onzebaandert/lora-tuinmeetnet-v2/docs/FSD_LoRa_tuinmeetnet_v0_3.docx

Functioneel Specificatie Document

LoRa tuinmeetnet met RTC-gestuurde soil nodes, aggregator, LoRa uplink en MQTT-ontvangst

Versie | 0.2 conceptupdate
Datum | 18 april 2026
Doel | Vastleggen van de functionele werking, timing, hardware-architectuur en interfaces van het huidige veldsysteem.
Reikwijdte | SOIL1, SOIL2, Aggregator, XIAO C3 LoRa node, Heltec LoRa zender, T-Beam/receiver, MQTT, Node-RED, InfluxDB en Grafana.

Dit document vervangt de eerdere conceptversie door expliciet vast te leggen dat de systeemtiming door DS3231-RTC-modules wordt bepaald en door aanvullende hardware- en functiebeschrijvingen voor de soil nodes en aggregator op te nemen.

# 1. Doel en scope

Het project realiseert een energiezuinig tuinmeetnet waarin twee XIAO ESP32-C3 soil nodes via ESP-NOW rapporteren aan een XIAO ESP32-C3 aggregator. De aggregator stuurt een compact vast uplinkframe door naar een XIAO C3 LoRa node. Deze zet de informatie om naar een JSON-regel voor een Heltec LoRa-zender, die de payload via LoRa verstuurt naar een ontvangerlaag (bijvoorbeeld T-Beam), waarna publicatie naar MQTT, parsing in Node-RED en opslag in InfluxDB/Grafana plaatsvindt.

Binnen scope vallen de functionele datastroom, de node-rollen, de timing op basis van DS3231-RTC, de payloaddefinities, de energiehuishouding en de softwarematige verantwoordelijkheden per node. Buiten scope vallen mechanische constructie, waterdichte behuizing, langdurige milieuvalidatie, formele EMC-certificering en productierijpe beveiliging.

# 2. Systeemcontext en hoofdketen

De functionele hoofdketen van het systeem is lineair, maar de betrouwbaarheid wordt vergroot door gefaseerde wake-momenten, ACK-mechanismen en herhaalde uplinktransmissies in de tussenlaag.

Laag / node | Primaire hardware | Transport | Hoofdfunctie
SOIL1 | XIAO ESP32-C3 + DS3231 + RS485 + CWT sensor | Modbus RTU + ESP-NOW | Leest vocht, temperatuur, EC en pH; stuurt SoilPacket met ACK-afhandeling.
SOIL2 | XIAO ESP32-C3 + DS3231 + RS485 + ZTS sensor | Modbus RTU + ESP-NOW | Leest vocht en temperatuur; stuurt SoilPacket met ACK-afhandeling.
Aggregator | XIAO ESP32-C3 + DS3231 | ESP-NOW | Ontvangt SoilPackets, ACKt zenders, verrijkt met eigen batterij/case-temp en bouwt vaste AggUplink97.
LoRa node C3 | XIAO ESP32-C3 + DS3231 + MOSFET + UART | ESP-NOW + UART | Luistert naar AggUplink97, converteert naar compacte JSON en voedt de Heltec alleen tijdens uplink.
Heltec LoRa zender | Heltec board met SX1262 | LoRa | Zend de ontvangen JSON-payload via LoRa uit.
Receiver | T-Beam V1 of vergelijkbare RX-node | LoRa + WiFi + MQTT | Ontvangt LoRa, voegt LoRa RSSI/SNR toe en publiceert naar MQTT.
Applicatielaag | Node-RED + InfluxDB + Grafana | MQTT | Parseert payloads, splitst measurements en visualiseert/corrigeert trends.

# 3. Hardware-architectuur per node

## 3.1 Soil nodes (gemeenschappelijk patroon)

Beide soil nodes zijn gebaseerd op een XIAO ESP32-C3 en gebruiken een DS3231-RTC voor phase-aligned deep-sleep wakes. De externe RS485-sensor wordt via een MOSFET alleen tijdens de meetfase van spanning voorzien. Daarmee wordt rustverbruik beperkt en wordt de sensorinterface buiten de actieve meetvensters ontkoppeld.

- Controller: XIAO ESP32-C3.
- RTC: DS3231 op I2C; INT-lijn naar WAKE_PIN voor deep-sleep wake.
- Sensorbus: RS485 transceiver met DE/RE-direction control.
- Voedingsbesparing: sensorvoeding via MOSFET, alleen actief tijdens sensor warm-up en Modbus-uitlezing.
- Lokale metingen: accuspanning (VBAT) en case temperature via DS3231 interne temperatuursensor.
- Communicatie naar aggregator: ESP-NOW op kanaal 6 met ACK-wachtvenster en retries.

## 3.2 SOIL1

SOIL1 gebruikt een CWT Modbus-sensor. De huidige code leest adres 1 op 4800 baud met functie 0x03 vanaf register 0x0000, lengte 7. Functioneel levert SOIL1 bodemtemperatuur, vocht, EC en pH, plus lokale case temperature en batterijspanning.

- Meetwaarden in payload: soil temperature, soil humidity, EC raw, pH, case temperature en vbat.
- Wachtprofiel: sensor warm-up 2500 ms, maximaal 5 Modbus-pogingen.
- ESP-NOW identificatie: SoilPacket.id = 1.
- Fase in 5-minutencyclus: PHASE_SECOND = 8.

## 3.3 SOIL2

SOIL2 gebruikt een ZTS Modbus-sensor. De huidige code leest adres 1 op 4800 baud met functie 0x04 vanaf register 0x0000, lengte 2. Functioneel levert SOIL2 bodemtemperatuur en vocht, plus lokale case temperature en batterijspanning.

- Meetwaarden in payload: soil temperature, moisture percentage, case temperature en vbat.
- Wachtprofiel: sensor warm-up 3200 ms, maximaal 5 Modbus-pogingen.
- ESP-NOW identificatie: SoilPacket.id = 2.
- Fase in 5-minutencyclus: PHASE_SECOND = 16.

## 3.4 Aggregator (AGG)

De aggregator is eveneens een XIAO ESP32-C3 met DS3231. Deze node luistert na wake gedurende een vast venster naar binnenkomende SoilPackets. Voor elke geaccepteerde soil node wordt de ontvangen sensorinhoud opgeslagen en wordt de ontvangen ESP-NOW RSSI in Soil22.rsv0 (low byte, int8) weggeschreven. Daarnaast leest de AGG zijn eigen batterijspanning en case temperature.

- Luistervenster: LISTEN_MS = 30000 ms.
- Fase in 5-minutencyclus: WAKE_SECOND = 5.
- ACK: 8-byte Ack met session_id, seq en ok-flag.
- Ondersteuning voor drie externe bronnodes; in de huidige specificatie zijn SOIL1 en SOIL2 volledig benoemd, de derde bron blijft reserve/optioneel.
- Uplink naar mesh/LoRa node: 97-byte AggUplink97, momenteel acht keer verzonden met 250 ms tussenruimte.

## 3.5 LoRa uplinknode en ontvangerlaag

Na aggregatie wordt de data door een aparte XIAO C3 LoRa node ontvangen. Deze node luistert via ESP-NOW naar de 97-byte aggregator-uplink, bouwt een compacte JSON-string, schakelt via een MOSFET de Heltec LoRa-zender in en levert de JSON via UART aan. De Heltec verzorgt uitsluitend de LoRa-uitzending. Aan de ontvangende zijde wordt in de huidige opstelling een T-Beam gebruikt om LoRa te ontvangen en naar MQTT te publiceren.

- XIAO C3 LoRa node: DS3231-gestuurde wake, ESP-NOW ontvangst, JSON-opbouw, MOSFET power gating voor Heltec en UART-bridge.
- Heltec zender: leest één UART-regel en zendt deze via LoRa uit; testsketches kunnen ook zelfstandig periodieke testberichten uitzenden.
- T-Beam receiver: voegt LoRa RSSI/SNR aan het bericht toe en publiceert naar MQTT.

# 4. RTC-timing en wake-orchestratie

Een kernpunt van dit project is dat de timing van het volledige systeem op DS3231-RTC-modules is gebaseerd. De RTC bepaalt per node wanneer de deep-sleep wordt verlaten en maakt daarmee de communicatieketen deterministic genoeg om energiezuinig te blijven. Zonder dit mechanisme zouden soil nodes, aggregator en uplinknode elkaar vaak missen.

Alle XIAO-gebaseerde nodes gebruiken DS3231 Alarm1 in interruptmodus. De INT-lijn trekt WAKE_PIN laag; vervolgens wordt de volgende wake direct na afloop van de cyclus opnieuw in de RTC geprogrammeerd. Alleen bij een RTC-leesfout valt de code terug op timer-based wake.

Node | Cyclustijd | Fase-seconde | Functionele betekenis
Aggregator | 5 min | 05 | Wordt vroeg in de cyclus wakker en luistert 30 s naar soil nodes.
SOIL1 | 5 min | 08 | Meet, voedt sensor kortstondig, verstuurt SoilPacket en wacht op ACK.
SOIL2 | 5 min | 16 | Meet, voedt sensor kortstondig, verstuurt SoilPacket en wacht op ACK.
LoRa node C3 | 5 min | 05 | Wordt tegelijk met AGG wakker zodat de daaropvolgende uplink binnen het luistervenster valt.

Tabel 1. Fasegebaseerde timing van de huidige implementatie.

De gekozen seconden 05, 08 en 16 reduceren de kans op overlap tussen soil nodes en zorgen dat de AGG en LoRa node al actief zijn voordat de sensornodes hun meting afronden. Functioneel betekent dit dat timing niet alleen een optimalisatie is, maar een onderdeel van het protocolontwerp.

# 5. Functionele werking per cyclus

## 5.1 Soil node cyclus

- Node wordt gewekt door DS3231 Alarm1.
- Node leest lokale batterijspanning en case temperature.
- Node schakelt RS485-sensor via MOSFET in, wacht op warm-up en voert Modbus-uitlezing uit.
- Meetdata wordt verpakt in SoilPacket (28 bytes).
- Packet wordt via ESP-NOW naar AGG verstuurd; de node wacht op ACK en doet maximaal twee retries wanneer nodig.
- Na afloop wordt de volgende RTC-alarmering berekend en gaat de node terug naar deep sleep.

## 5.2 Aggregatorcyclus

- AGG wordt gewekt door DS3231 en activeert WiFi STA + ESP-NOW op het vaste kanaal.
- Gedurende 30 s worden SoilPackets ontvangen, gevalideerd op magic en bron-MAC, en per node opgeslagen.
- Voor elk geldig packet wordt een Ack teruggestuurd.
- Na het luistervenster bouwt AGG een AggUplink97 met één self-item en maximaal drie bronitems.
- De uplink wordt met oplopende agg_seq meerdere keren naar de uplinknode verstuurd om de kans op ontvangst te vergroten.
- Daarna wordt de volgende RTC-wekker gezet en gaat de AGG in deep sleep.

## 5.3 LoRa uplink- en receivertak

- De XIAO C3 LoRa node ontvangt AggUplink97, vertaalt de velden naar een compacte JSON-root met array s[].
- De Heltec-zender krijgt alleen tijdens de uplink spanning, ontvangt de JSON-regel via UART en zendt deze via LoRa uit.
- De T-Beam ontvangt de LoRa-payload, meet lr en ls (LoRa RSSI en SNR) en publiceert het bericht naar MQTT.
- Node-RED parseert het bericht, splitst het naar measurements agg, soil1, soil2 en eventueel soil3, en schrijft de velden weg naar InfluxDB/Grafana.

# 6. Datamodellen en interfaces

## 6.1 Binary payloads in de ESP-NOW-laag

Struct | Grootte | Herkomst | Beschrijving
Soil22 | 22 bytes | Soil / Agg | Gestandaardiseerd meetrecord met session_id, seq, t_x10, h_x10, ec_raw, case_x10, vbat_mv, ph_x10, flags en rsv0.
SoilPacket | 28 bytes | Soil -> AGG | Envelope met magic, node-id, Soil22 en 4 bytes padding.
Ack | 8 bytes | AGG -> Soil | Bevestiging van session_id + seq met ok-flag.
AggUplink97 | 97 bytes | AGG -> uplinknode | agg_sid, agg_seq, count en vier Soil22-slots (slot 0 = self, slot 1..3 = bronnodes).

## 6.2 Soil22 veldsemantiek

Veld | Type | Schaal | Gebruik
session_id | uint32 | - | Persistente sessie-id per node over deep sleep heen.
seq | uint16 | +1 per meting | Monotone teller per node; gebruikt voor diagnose en ACK-correlatie.
t_x10 | int16 | /10 | Bodemtemperatuur of sensortemperatuur.
h_x10 | uint16 | /10 | Vochtigheid of moisture percentage.
ec_raw | uint16 | raw | Alleen SOIL1/CWT gebruikt dit veld functioneel.
case_x10 | int16 | /10 | Case temperature, afgeleid uit DS3231 temperatuursensor.
vbat_mv | uint16 | mV | Lokale batterijspanning van de node.
ph_x10 | uint16 | /10 | Alleen SOIL1/CWT gebruikt dit veld functioneel.
flags | uint16 | bitmask | Status van de lokale meting; 0x0001 betekent sensoruitlezing gelukt.
rsv0 | uint16 | vrij / low byte | In AGG low byte gebruikt voor ontvangen ESP-NOW RSSI van soil node.

## 6.3 UART, LoRa en MQTT JSON

De XIAO C3 LoRa node zet de aggregator-uplink om naar een compacte JSON. Aan de ontvangende zijde voegt de receiver lr en ls toe.

Veld | Niveau | Beschrijving
a | root | agg_seq
r | root | door uplinknode doorgegeven aggregator/ESP-NOW RSSI
av | root | aggregator battery voltage in mV
ac | root | aggregator case temperature in °C
mv | root | mesh/uplinknode battery voltage in mV
mc | root | mesh/uplinknode case temperature in °C
s | root | array met soilrecords; soil1 bevat [temp, hum, ec, case, vbat, rssi], soil2/soil3 bevatten [temp, hum, case, vbat, rssi]

De receiver publiceert dezelfde payload aangevuld met lr en ls. In Node-RED kunnen deze velden direct worden opgeslagen of eerst worden genormaliseerd naar lora_rssi en lora_snr.

{"a":123,"r":-61,"av":4120,"ac":24.5,"mv":0,"mc":23.8,"s":[[21.4,55.2,678,24.0,3980,-49],[20.8,57.1,23.5,4010,-52]],"lr":-105.0,"ls":-10.0}

# 7. Energiebeheer en robuustheid

- Soil-sensoren krijgen alleen voeding tijdens de actieve meetfase via MOSFET-switching; hiermee wordt sensor-rustverbruik vermeden.
- Alle XIAO-nodes gaan na afronding terug naar deep sleep en worden primair door de DS3231-wekker opnieuw geactiveerd.
- ACK-gedrag op de soil nodes voorkomt stille dataverliezen dicht bij de bron.
- AGG verstuurt de 97-byte uplink meerdere keren naar de uplinknode, waarmee de kans toeneemt dat ten minste één exemplaar tijdens het luistervenster wordt ontvangen.
- Bij RTC-fouten wordt naar timer wake teruggevallen; daarmee blijft het systeem functioneel maar minder precies gesynchroniseerd.
- Session_id en sequence-tellers worden in RTC_DATA_ATTR bewaard zodat deep sleep geen verlies van correlatie veroorzaakt.

# 8. Belangrijkste configureerbare parameters

Parameter | Huidige waarde | Effect
INTERVAL_MINUTES | 5 | Cyclustijd van soil nodes, AGG en uplinknode.
ESPNOW_WIFI_CHANNEL | 6 | Vast kanaal voor soil -> AGG -> uplinknode.
SOIL1 PHASE_SECOND | 8 | Zendmoment van SOIL1 binnen de 5-minutencyclus.
SOIL2 PHASE_SECOND | 16 | Zendmoment van SOIL2 binnen de 5-minutencyclus.
AGG LISTEN_MS | 30000 | Luisterduur van AGG voor SoilPackets.
AGG uplink repeats | 8 x 250 ms gap | Robuustheid van AGG -> uplinknode.
LoRa profiel | freq/BW/SF/CR/sync/power | Bepaalt RF-marge en airtime van de Heltec-zender en receiver.

# 9. Functionele eisen en acceptatiepunten

- Het systeem moet zonder handmatige interventie cyclisch kunnen meten, bundelen, uplinken en loggen op basis van RTC-gestuurde wakes.
- SOIL1 en SOIL2 moeten hun sensorvoeding na afloop van de meetfase uitschakelen.
- De AGG moet geldige SoilPackets ACKen en moet de laatst ontvangen data per bronnode in de uplink kunnen opnemen.
- De uplinkketen moet end-to-end leiden tot ten minste de measurements agg, soil1 en soil2 in InfluxDB/Grafana.
- Sequence-tellers moeten diagnose van gemiste cycli mogelijk maken.
- Een langdurige veldrun zonder fysieke wijzigingen in de opstelling is de primaire manier om structurele stabiliteit te beoordelen.

# 10. Bekende aandachtspunten

- DS3231 is een functioneel kernonderdeel van het protocol; verkeerde fase-instellingen of verlies van RTC-sync kunnen direct resulteren in gemiste vensters.
- RF-gedrag blijft gevoelig voor antennekwaliteit, kabel/pigtail-verlies, vocht, plaatsing en polarisatie.
- De AGG-code ondersteunt een derde externe bronnode (WEMOS-slot), maar die is in deze revisie nog niet functioneel uitgewerkt.
- De ontvangerlaag (T-Beam / MQTT) moet reconnect-veilig zijn bij lange tussenpozen tussen LoRa-pakketten.

# 11. Aanbevolen vervolgstappen voor versie 1.0

- Blokdiagram en pinout-bijlage actueel houden bij hardwarewijzigingen, zodat documentatie en bekabeling synchroon blijven.
- Het derde sensorkanaal (soil3 / WEMOS-slot) formeel specificeren of expliciet uit scope halen.
- Definitieve veldvalidatie over meerdere dagen opnemen als aparte test- of verificatiebijlage.
- Bekende goede antenne- en opstelconfiguraties documenteren, zodat RF-issues later sneller zijn uit te sluiten.

# 12. Systeemblokdiagram

Onderstaand blokdiagram vat de functionele keten samen vanaf de RTC-gestuurde soil nodes tot en met MQTT, Node-RED, InfluxDB en Grafana. Het diagram is gebaseerd op de actuele veldopstelling en op de meest recente AGG-, SOIL1-, SOIL2-, LoRa-node- en receiver-sketches.

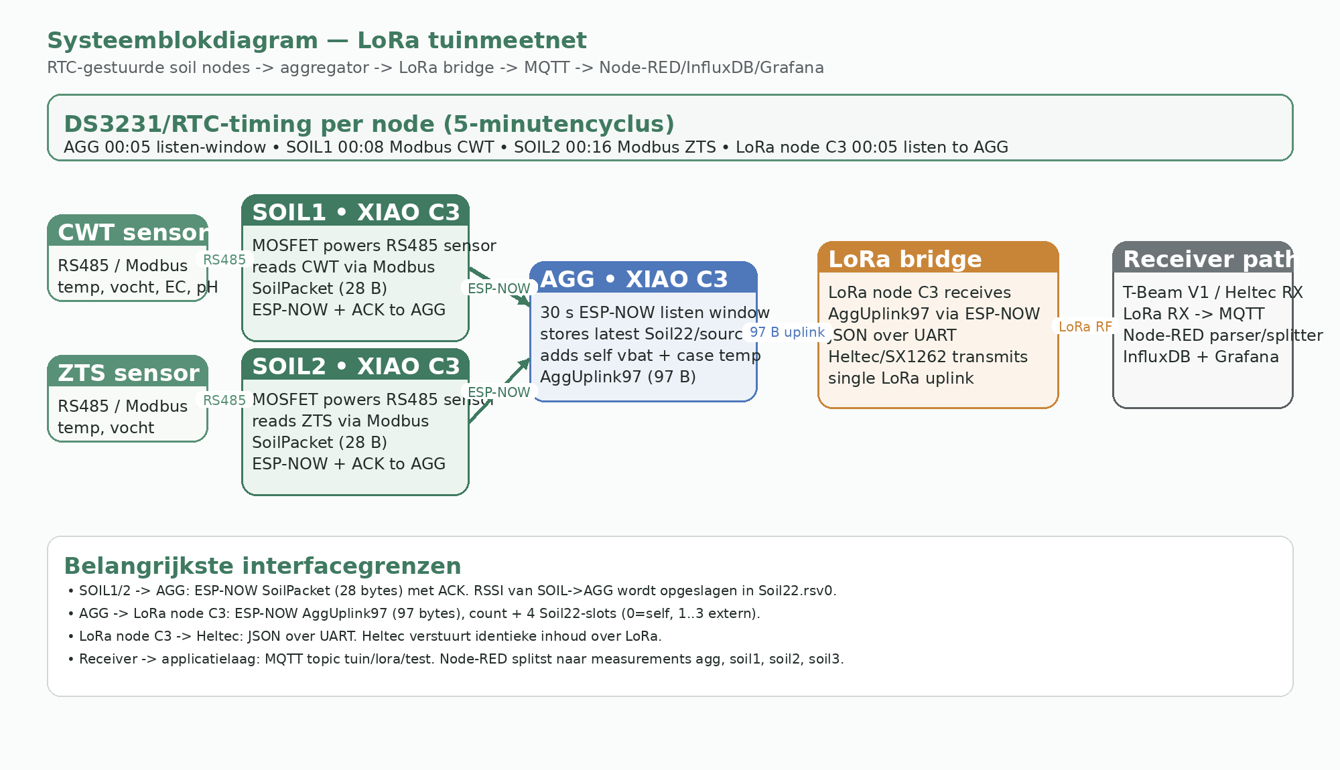
[picture p1: figure]

Figuur 1. Blokdiagram van de RTC-gestuurde datastroom en de hoofdinterfaces in het LoRa tuinmeetnet.

De DS3231 bepaalt per node zowel het wake-moment als de fase binnen de 5-minutencyclus. Daardoor worden metingen, ESP-NOW-luistervensters en de bridge-actie van de LoRa-node voorspelbaar en herhaalbaar getriggerd.

# 13. Pinout-bijlage per node

Deze bijlage is afgeleid uit de laatst aangeleverde sketches. Alleen pinnen die expliciet in de code zijn geconfigureerd of een directe systeemaansluiting vertegenwoordigen, zijn opgenomen. Waar in de code analoge aliassen zoals A1 worden gebruikt, blijft die benaming bewust gehandhaafd.

## 13.1 SOIL1 — XIAO ESP32-C3 met CWT RS485-sensor

Signaal / aansluiting | XIAO / board-pin | Richting | Functie / opmerking
DS3231 SDA | GPIO6 | I2C | SDA-lijn naar DS3231 RTC-module.
DS3231 SCL | GPIO7 | I2C | SCL-lijn naar DS3231 RTC-module.
DS3231 INT/SQW | GPIO2 | Input | Wake-signaal van de RTC voor deep sleep / alarm.
RS485 RX | GPIO21 | UART RX | Ontvangstlijn naar RS485-transceiver voor Modbus.
RS485 TX | GPIO20 | UART TX | Zendlijn naar RS485-transceiver voor Modbus.
RS485 DE/RE | GPIO4 | Output | Stuurt zend/ontvangstmodus van de RS485-transceiver.
Sensor power MOSFET | GPIO5 | Output | Schakelt de voeding van de CWT-sensor alleen tijdens de meetfase in.
VBAT meetpunt | A1 | Analog input | Meet accuspanning van de SOIL1-node.
ESP-NOW radio | Wi-Fi STA | RF | Stuurt SoilPacket naar de AGG-node en wacht op ACK.

## 13.2 SOIL2 — XIAO ESP32-C3 met ZTS RS485-sensor

Signaal / aansluiting | XIAO / board-pin | Richting | Functie / opmerking
DS3231 SDA | GPIO7 | I2C | SDA-lijn naar DS3231 RTC-module; in deze sketch omgewisseld t.o.v. SOIL1.
DS3231 SCL | GPIO6 | I2C | SCL-lijn naar DS3231 RTC-module; in deze sketch omgewisseld t.o.v. SOIL1.
DS3231 INT/SQW | GPIO2 | Input | Wake-signaal van de RTC voor deep sleep / alarm.
RS485 RX | GPIO21 | UART RX | Ontvangstlijn naar RS485-transceiver voor Modbus.
RS485 TX | GPIO20 | UART TX | Zendlijn naar RS485-transceiver voor Modbus.
RS485 DE/RE | GPIO4 | Output | Stuurt zend/ontvangstmodus van de RS485-transceiver.
Sensor power MOSFET | GPIO5 | Output | Schakelt de voeding van de ZTS-sensor alleen tijdens de meetfase in.
VBAT meetpunt | GPIO3 | Analog input | Meet accuspanning van de SOIL2-node.
ESP-NOW radio | Wi-Fi STA | RF | Stuurt SoilPacket naar de AGG-node en wacht op ACK.

## 13.3 AGG — XIAO ESP32-C3 aggregator

Signaal / aansluiting | XIAO / board-pin | Richting | Functie / opmerking
DS3231 SDA | GPIO6 | I2C | SDA-lijn naar DS3231 RTC-module.
DS3231 SCL | GPIO7 | I2C | SCL-lijn naar DS3231 RTC-module.
DS3231 INT/SQW | GPIO2 | Input | Wake-signaal van de RTC; bepaalt de 5-minutencyclus en het listen-window.
VBAT meetpunt | A1 | Analog input | Meet de accuspanning van de aggregator.
ESP-NOW radio | Wi-Fi STA | RF | Ontvangt SoilPacket-berichten van soil nodes, ACKt terug en verstuurt AggUplink97 naar de LoRa-node C3.

## 13.4 LoRa-node C3 — XIAO ESP32-C3 bridge van ESP-NOW naar UART

Signaal / aansluiting | XIAO / board-pin | Richting | Functie / opmerking
DS3231 SDA | GPIO6 | I2C | SDA-lijn naar DS3231 RTC-module.
DS3231 SCL | GPIO7 | I2C | SCL-lijn naar DS3231 RTC-module.
DS3231 INT/SQW | GPIO2 | Input | Wake-signaal van de RTC voor deep sleep / alarm.
UART TX naar Heltec | GPIO9 | UART TX | Stuurt de JSON-uplink door naar de Heltec LoRa-zender.
Heltec power MOSFET | GPIO5 | Output | Schakelt de voeding van de Heltec alleen in tijdens de bridge/transmit-fase.
ESP-NOW radio | Wi-Fi STA | RF | Ontvangt AggUplink97 van de AGG-node.

## 13.5 Heltec LoRa node — UART naar SX1262 uplink

Signaal / aansluiting | XIAO / board-pin | Richting | Functie / opmerking
UART RX van XIAO C3 | GPIO46 | UART RX | Ontvangt één JSON-regel van de LoRa-node C3.
SX1262 NSS | GPIO8 | SPI CS | Chip select voor de LoRa-radio.
SX1262 DIO1 | GPIO14 | Input | IRQ / statuslijn van de SX1262.
SX1262 NRST | GPIO12 | Output | Resetlijn van de SX1262.
SX1262 BUSY | GPIO13 | Input | Busy-statuslijn van de SX1262.
SPI SCK | GPIO9 | SPI | Kloklijn voor de SX1262.
SPI MISO | GPIO11 | SPI | MISO-lijn voor de SX1262.
SPI MOSI | GPIO10 | SPI | MOSI-lijn voor de SX1262.

## 13.6 T-Beam V1 receiver — LoRa RX naar MQTT

Signaal / aansluiting | XIAO / board-pin | Richting | Functie / opmerking
SX1276 NSS | GPIO18 | SPI CS | Chip select voor de T-Beam LoRa-radio.
SX1276 DIO0 | GPIO26 | Input | RX/TX IRQ-lijn van de SX1276.
SX1276 RST | GPIO23 | Output | Resetlijn van de SX1276.
SX1276 DIO1 | GPIO33 | Input | Tweede interrupt/statuslijn van de SX1276.
SPI SCK | GPIO5 | SPI | Kloklijn voor de SX1276.
SPI MISO | GPIO19 | SPI | MISO-lijn voor de SX1276.
SPI MOSI | GPIO27 | SPI | MOSI-lijn voor de SX1276.
Wi-Fi client | ESP32 STA | Network | Publiceert ontvangen LoRa-berichten naar MQTT.

LoRa tuinmeetnet FSD v0.3
