onzebaandert/lora-tuinmeetnet-v2/sketches/CLAUDE_LORA_VV_SENSORSTATION_V2/CLAUDE_LORA_VV_SENSORSTATION_V2.ino

/*
  SKETCH : LORA_VV_SENSORSTATION_V2
  DEVICE : ESP32-C3 Super Mini
  ROLE   : Licht + temp + vochtigheid + DS18B20 + batlev naar AGG via ESP-NOW
  SENSOR : BH1750 (I2C 0x23) + SHT3x (I2C 0x44) + DS18B20 (OneWire GPIO2)

  Hardware aansluitingen:
    Super Mini GPIO3 (SDA) ──── BH1750 SDA  +  SHT3x SDA
    Super Mini GPIO4 (SCL) ──── BH1750 SCL  +  SHT3x SCL
    Super Mini GPIO1       ──── spanningsdeler uitgang bat+
                                (gemeten: divider=2.60V bat=3.77V → ratio=1.46)
    Super Mini GPIO2       ──── DS18B20 DATA  (4.7K pull-up naar 3.3V)
    LET OP: GPIO6-GPIO11 zijn SPI-flash pins op ESP32-C3, NIET gebruiken!
    BH1750 ADDR            ──── GND  (adres 0x23)
    SHT3x  ADDR            ──── GND  (adres 0x44)

  Packet layout (Soil22 struct, id=5):
    t_x10    = SHT3x temperatuur × 10  (°C)
    h_x10    = SHT3x vochtigheid × 10  (%RH)
    ec_raw   = BH1750 lux (uint16, 0–65535)
    case_x10 = DS18B20 temperatuur × 10 (°C)
    vbat_mv  = batterij in mV
    ph_x10   = 0 (niet gebruikt)
    flags    = 0x0001 BH1750 OK | 0x0002 SHT3x OK | 0x0004 DS18B20 OK

  Libraries:
    - BH1750         door Christopher Laws
    - Adafruit SHT31 door Adafruit
    - OneWire        door Paul Stoffregen
    - DallasTemperature door Miles Burton
    - Wire           (ingebouwd)
*/

#include <Arduino.h>
#include <WiFi.h>
#include <esp_now.h>
#include <Wire.h>
#include "esp_sleep.h"
#include <BH1750.h>
#include <Adafruit_SHT31.h>
#include <OneWire.h>
#include <DallasTemperature.h>

#define SKETCH_TAG "VV_SENSORSTATION_V2"

/* ============== CONFIG ============== */
#define ESPNOW_WIFI_CHANNEL  6
static const uint8_t AGG_MAC[6] = {0xB0,0xA6,0x04,0x07,0xA2,0x80};

#define I2C_SDA           3    // Super Mini SDA
#define I2C_SCL           4    // Super Mini SCL

#define DS18B20_PIN       2    // DS18B20 data pin (4.7K pull-up naar 3.3V) — GPIO6-11 zijn SPI flash!

#define SLEEP_SEC         30
#define DEV_HOLD_MS       8000UL

// Batterij: spanningsdeler naar GPIO1, ratio gekalibreerd op 3.77V bat / 2.60V divider = 1.46
#define VBAT_PIN          1
#define VBAT_RATIO        1.46f

#define ACK_WAIT_MS       150
#define MAX_RETRIES       2
/* ==================================== */

/* ===== packet struct ===== */
#pragma pack(push, 1)
struct __attribute__((packed)) Soil22 {
  uint32_t session_id;
  uint16_t seq;
  int16_t  t_x10;     // SHT3x temp × 10
  uint16_t h_x10;     // SHT3x vochtigheid × 10
  uint16_t ec_raw;    // BH1750 lux
  int16_t  case_x10;  // DS18B20 temp × 10
  uint16_t vbat_mv;
  uint16_t ph_x10;    // niet gebruikt
  uint16_t flags;
  uint16_t rsv0;
};
#pragma pack(pop)
static_assert(sizeof(Soil22) == 22, "Soil22 size");

#pragma pack(push, 1)
struct __attribute__((packed)) SoilPacket {
  uint8_t magic;
  uint8_t id;
  Soil22  s;
  uint8_t pad[4];
};
#pragma pack(pop)
static_assert(sizeof(SoilPacket) == 28, "SoilPacket size");

#pragma pack(push, 1)
struct __attribute__((packed)) Ack {
  uint32_t session_id;
  uint16_t seq;
  uint8_t  ok;
  uint8_t  pad;
};
#pragma pack(pop)
static_assert(sizeof(Ack) == 8, "Ack size");

/* ===== VBAT ===== */
static uint16_t read_vbat_mv(){
  analogSetAttenuation(ADC_11db);
  for (int i = 0; i < 5; i++) { analogReadMilliVolts(VBAT_PIN); delay(10); }

  const int N = 20;
  uint32_t s[N];
  for (int i = 0; i < N; i++) { s[i] = analogReadMilliVolts(VBAT_PIN); delay(10); }
  for (int i = 0; i < N-1; i++)
    for (int j = 0; j < N-1-i; j++)
      if (s[j] > s[j+1]) { uint32_t t = s[j]; s[j] = s[j+1]; s[j+1] = t; }
  uint32_t sum = 0;
  for (int i = 5; i < 15; i++) sum += s[i];
  float avg_mv = sum / 10.0f;
  return (uint16_t)(avg_mv * VBAT_RATIO + 0.5f);
}

/* ===== ESP-NOW ACK ===== */
static volatile bool     ack_got = false;
static volatile uint32_t ack_sid = 0;
static volatile uint16_t ack_seq = 0;

static void on_ack_recv(const esp_now_recv_info_t *info, const uint8_t *data, int len){
  (void)info;
  if (!data || len < (int)sizeof(Ack)) return;
  Ack a; memcpy(&a, data, sizeof(a));
  if (a.ok != 1) return;
  ack_sid = a.session_id; ack_seq = a.seq; ack_got = true;
}
static bool wait_ack(uint32_t sid, uint16_t seqv){
  ack_got = false;
  uint32_t t0 = millis();
  while (millis() - t0 < ACK_WAIT_MS) {
    if (ack_got && ack_sid == sid && ack_seq == seqv) return true;
    delay(1);
  }
  return false;
}

/* ===== retained ===== */
RTC_DATA_ATTR static uint32_t session_id = 0;
RTC_DATA_ATTR static uint16_t seq = 0;

/* ===== SETUP ===== */
void setup(){
  Serial.begin(115200);
  delay(120);
  Serial.println();
  Serial.println("=================================================");
  Serial.println(SKETCH_TAG);
  Serial.println("=================================================");

  if (DEV_HOLD_MS > 0) {
    uint32_t t0 = millis();
    while (millis() - t0 < DEV_HOLD_MS) delay(10);
  }

  Wire.begin(I2C_SDA, I2C_SCL);

  // BH1750
  BH1750 lightMeter;
  bool bh_ok = lightMeter.begin(BH1750::CONTINUOUS_HIGH_RES_MODE);
  delay(180);
  float lux = bh_ok ? lightMeter.readLightLevel() : -1.0f;
  uint16_t lux_u16 = (bh_ok && lux >= 0) ? (uint16_t)min((float)65535, lux) : 0;
  Serial.printf("[BH1750]  ok=%d lux=%.1f\n", bh_ok ? 1 : 0, lux);

  // SHT3x
  Adafruit_SHT31 sht3x;
  bool sht_ok = sht3x.begin(0x44);
  float sht_temp = sht_ok ? sht3x.readTemperature() : NAN;
  float sht_hum  = sht_ok ? sht3x.readHumidity()    : NAN;
  if (!sht_ok || isnan(sht_temp)) { sht_ok = false; sht_temp = 0.0f; sht_hum = 0.0f; }
  Serial.printf("[SHT3x]   ok=%d T=%.1f H=%.1f\n", sht_ok ? 1 : 0, sht_temp, sht_hum);

  // DS18B20
  OneWire oneWire(DS18B20_PIN);
  DallasTemperature ds18(&oneWire);
  ds18.begin();
  bool ds_ok = (ds18.getDeviceCount() > 0);
  float ds_temp = 0.0f;
  if (ds_ok) {
    ds18.requestTemperatures();
    delay(750);  // 12-bit conversie duurt max 750ms
    ds_temp = ds18.getTempCByIndex(0);
    if (ds_temp == DEVICE_DISCONNECTED_C) { ds_ok = false; ds_temp = 0.0f; }
  }
  Serial.printf("[DS18B20] ok=%d T=%.2f\n", ds_ok ? 1 : 0, ds_temp);

  uint16_t vbat_mv = read_vbat_mv();
  Serial.printf("[VBAT]    %.2fV  (VBAT_RATIO=%.2f)\n", vbat_mv / 1000.0f, VBAT_RATIO);

  WiFi.mode(WIFI_STA);
  WiFi.setSleep(false);
  WiFi.setChannel(ESPNOW_WIFI_CHANNEL);
  while (!WiFi.STA.started()) delay(1);

  if (session_id == 0) session_id = esp_random();

  Serial.printf("[STNST]   MAC=%s sid=0x%08lX\n",
                WiFi.macAddress().c_str(), (unsigned long)session_id);

  bool delivered = false;

  if (esp_now_init() != ESP_OK) {
    Serial.println("[ESPNOW] init FAILED");
  } else {
    esp_now_register_recv_cb(on_ack_recv);

    esp_now_peer_info_t p{};
    memcpy(p.peer_addr, AGG_MAC, 6);
    p.channel = ESPNOW_WIFI_CHANNEL;
    p.encrypt = false;
    esp_err_t e = esp_now_add_peer(&p);
    if (e != ESP_OK && e != ESP_ERR_ESPNOW_EXIST)
      Serial.printf("[ESPNOW] add_peer FAILED err=%d\n", (int)e);

    uint16_t flags = 0;
    if (bh_ok)  flags |= 0x0001;
    if (sht_ok) flags |= 0x0002;
    if (ds_ok)  flags |= 0x0004;

    SoilPacket pkt{};
    pkt.magic        = 0xA1;
    pkt.id           = 5;
    pkt.s.session_id = session_id;
    pkt.s.seq        = ++seq;
    pkt.s.t_x10      = (int16_t)lroundf(sht_temp * 10.0f);
    pkt.s.h_x10      = (uint16_t)lroundf(sht_hum  * 10.0f);
    pkt.s.ec_raw     = lux_u16;
    pkt.s.case_x10   = (int16_t)lroundf(ds_temp   * 10.0f);
    pkt.s.vbat_mv    = vbat_mv;
    pkt.s.ph_x10     = 0;
    pkt.s.flags      = flags;
    pkt.s.rsv0       = 0;

    for (int attempt = 0; attempt <= MAX_RETRIES; attempt++) {
      esp_err_t txe = esp_now_send(AGG_MAC, (const uint8_t*)&pkt, sizeof(pkt));
      bool tx_ok  = (txe == ESP_OK);
      bool ack_ok = tx_ok ? wait_ack(pkt.s.session_id, pkt.s.seq) : false;

      Serial.printf("[TX] seq=%u attempt=%d tx=%d ack=%d lux=%u T_sht=%.1f H=%.1f T_ds=%.2f vbat=%.2fV flags=0x%04X\n",
                    (unsigned)pkt.s.seq, attempt, tx_ok?1:0, ack_ok?1:0,
                    (unsigned)lux_u16, sht_temp, sht_hum, ds_temp,
                    vbat_mv/1000.0f, (unsigned)flags);

      if (ack_ok) { delivered = true; break; }
      delay(10);
    }
  }

  Serial.printf("[SLEEP] %d sec (delivered=%d)\n", SLEEP_SEC, delivered ? 1 : 0);
  esp_sleep_enable_timer_wakeup((uint64_t)SLEEP_SEC * 1000000ULL);
  WiFi.mode(WIFI_OFF);
  Serial.flush();
  esp_deep_sleep_start();
}

void loop(){}
