onzebaandert/lora-tuinmeetnet-v2/(commit log)

2026-04-30 Initial commit: LoRa tuinmeetnet v2
    - AGG: SOIL1/SOIL2/FLOW ontvanger met consecutief item-packing en sensor_slot in rsv0 high byte
    - SOIL1: CWT Modbus bodemvochtsensor (temp, vocht, EC, pH)
    - SOIL2: ZTS Modbus bodemvochtsensor (temp, vocht)
    - LORANODE_C3: mesh node met SOIL1/SOIL2/FLOW JSON formattering
    - LORANODE_HELTEC_OLED_V2: Heltec LoRa node met OLED display
    - RECEIVER_MQTT_HELTEC_V1: MQTT ontvanger op Heltec
    - WATERFLOW_V1: YF-201B waterflow sensor via ESP-NOW naar AGG
    - waterflow/: standalone WiFi AP webserver sketch (basis voor integratie)
2026-05-02 Heltec sketch: credentials naar extern bestand, MQTT broker IP bijgewerkt
    - WiFi en MQTT credentials verplaatst naar credentials.h (gitignored)
    - MQTT broker IP bijgewerkt naar 192.168.2.13
    - README.md toegevoegd met architectuur, services en JSON-formaat
    [CLAUDE_LORA_VV_RECEIVER_MQTT_HELTEC_V1.ino]
2026-05-04 Waterflow sketch: timer polling ipv GPIO wakeup
    MOSFET schakelt YF-201B elke 60s aan voor 500ms pultelling.
    GPIO wakeup verwijderd — werkte niet met MOSFET als stroomschakelaar.
    Elk uur (60 polls) versturing via ESP-NOW naar AGG.
2026-05-04 Waterflow sketch: solar versie met dag/nacht schema 08:00-20:00
    YF-201B permanent gevoed overdag via MOSFET → GPIO wakeup bij flow.
    NTP drift correctie elke cycle. Timer wakeup op 08:00 en 20:00.
    ESP-NOW send bij sessie klaar, ≥10L, of keepalive bij dagstart.
    [CLAUDE_LORA_VV_WATERFLOW_SOLAR_V1.ino]
2026-05-04 Waterflow: FLOW_PIN van GPIO7 naar GPIO4 (D2)
    GPIO7 ondersteunt geen deep sleep wakeup op ESP32-C3; GPIO0-5 wel.
2026-05-05 Waterflow: fix MOSFET LOW vóór count_pulses (meting bleef 0)
    wakeup cause nu als eerste bepaald zodat MOSFET HIGH blijft bij GPIO wakeup
    [CLAUDE_LORA_VV_WATERFLOW_SOLAR_V1.ino]
2026-05-05 Waterflow: MOSFET logica inverteerd voor P-channel F5305S
2026-05-05 Waterflow: revert MOSFET inversie — HIGH=aan is correct (zelfde als soil sensors)
    [CLAUDE_LORA_VV_WATERFLOW_SOLAR_V1.ino]
2026-05-06 Waterflow: TEST_MODE toegevoegd — knop op GPIO5 ipv YF-C01
    Drukknop tussen GPIO5 en GND wekt XIAO uit sleep.
    Simuleert 2 vensters × 225 pulsen ≈ 1L per druk (geen water nodig).
    Zet TEST_MODE op 0 voor productie.
2026-05-06 Waterflow: TEST_MODE 0 — productie (YF-C01)
2026-05-06 Waterflow: wacht op eerste puls voor zero-teller start
    Voorkomt dat sessie eindigt vóór flow begint (bijv. bij knoptest
    of trage kraaopening). Zero-vensters tellen pas na eerste detectie.
2026-05-08 Wemos D1 mini keepalive node met microWakeUpper
    MQTT keepalive node: deep sleep + eigen wakeuptimer (D0→RST),
    microWakeUpper trekt stroom via weerstand om powerbank alive te houden.
2026-05-08 Wemos D1 mini: DHT22 temperatuur+vochtigheid naar MQTT
    Deep sleep 60s, wake → DHT22 lezen → WiFi+MQTT publish → slaap.
    microWakeUpper met weerstand houdt powerbank alive tijdens sleep.
2026-05-08 DHT22 MQTT: sleep 25s ipv 60s — Sounix schakelt anders uit
2026-05-08 Heltec: batterijspanning op OLED via ingebouwde voltage divider
    GPIO1 + ADC_CTRL GPIO37, geen effect op TX timing.
2026-05-08 C3 LoRa node: VBAT code verwijderd (voltage divider defect)
    "mv" veld verdwijnt uit JSON output, read_mesh_vbat_mv() en defines weg.
2026-05-08 README: ontwerpuitgangspunten toegevoegd
    Low power, ESP-NOW, LoRa keuze en één TX per cyclus uitgelegd.
2026-05-09 BH1750 node: VBAT_CAL gekalibreerd op 0.668 voor GPIO4 ADC
2026-05-09 Systeemupdates: BH1750 slot, pH soil1, EC/10, waterflow frame, lnC3-vbat weg
    - AGG: BH1750 MAC toegevoegd als slot 4; AggUplink97 uitgebreid naar 5 items (119 bytes)
    - C3: uplink buffer 97→119, BH1750 parsing (sensor_slot=4) naar "bh" JSON key
    - C3: SOIL1 EC gedeeld door 10; pH toegevoegd aan SOIL1 JSON array
    - Grafana: BH1750 lux panel + casetemp/vbat; waterflow frame halve breedte/kleiner; lnC3-vbat verwijderd
2026-05-09 Grafana: bucket gecorrigeerd naar tuinsensoren_v2
2026-05-09 AGG: agg_seq naar NVS (Preferences) om teller reset bij brownout te voorkomen
    [CLAUDE_LORA_VV_AGG_V1.ino]
2026-05-09 DS3231 tijd-instellen sketch toegevoegd
    Nieuwe sketch CLAUDE_DS3231_SETTIME_V1 voor XIAO ESP32-C3:
    - Toont huidige DS3231 tijd elke seconde via Serial Monitor
    - Tijd instellen via HH:MM:SS invoer (115200 baud)
    - I2C op GPIO6 (SDA) / GPIO7 (SCL)
2026-05-09 Waterflow: FLOW_PIN gewijzigd naar GPIO5 (D3)
    YF-C01 switch aangesloten op D3 ipv D5
2026-05-11 Heltec MQTT: TBAT spanning meting toegevoegd via GPIO4
    Leest 0-25V sensor op GPIO4 uit met analogReadMilliVolts(), middelt
    8 samples, past 5:1 ratio en kalibratie factor toe, en stuurt het
    resultaat als lnHelTuin-tbat (mV) mee in elk MQTT bericht.
2026-05-11 Heltec MQTT: ingebouwde batterijspanning meting toegevoegd (GPIO1)
    Leest VBAT via GPIO1 met ingebouwde 4.9:1 spanningsdeler, schakelt
    ADC in/uit via VBAT_CTRL_PIN (GPIO37) voor power saving, middelt
    12 samples, en stuurt resultaat als lnHelTuin-vbat (mV) mee in MQTT.
2026-05-11 LoRa node: VBAT meting verbeterd; MQTT node VBAT ongedaan gemaakt
    LoRa node: readBattery() vervangen door read_vbat_mv() met
    analogReadMilliVolts(), 12 samples, 4.9:1 deler en kalibratie factor.
    Veldnaam gewijzigd van hv naar lnHelTuin-vbat (mV).
    MQTT node: per abuis toegevoegde VBAT meting teruggedraaid.
2026-05-11 LoRa node: VBAT fix — analogRead met ADC_11db ipv analogReadMilliVolts
    analogReadMilliVolts() kan crashen zonder eFuse kalibratie data.
    Vervangen door analogRead() met expliciete ADC_11db attenuation
    (bereik 0-3.3V) en handmatige mV conversie. Format strings %lu → %u.
    [CLAUDE_LORA_VV_LORANODE_HELTEC_OLED_V2.ino]
2026-05-11 LoRa node: teruggedraaid naar originele werkende versie
    VBAT wijzigingen veroorzaakten instabiel gedrag (random serial output,
    geen OLED). Sketch teruggezet naar staat van voor de VBAT toevoeging.
2026-05-11 LoRa node: VBAT meting toegevoegd als lnHelTuin-vbat (mV)
    Minimalistische aanpak op basis van werkende readBattery():
    analogRead() met 8 samples, ratio 4.9, kalibratie factor VBAT_CAL.
    Geen attenuation wijzigingen, geen analogReadMilliVolts().
2026-05-11 C3 LoRa node: VBAT meting toegevoegd als lnC3-vbat (mV)
    GPIO3 uitlezen via analogReadMilliVolts(), 12 samples gemiddelde,
    factor 1.478 (gemeten: 2700mV ADC bij 3990mV batterij), VBAT_CAL
    voor fine tuning. Veld lnC3-vbat in mV toegevoegd aan JSON output.
2026-05-11 Node-RED: lnHel_vbat en lnC3_vbat toevoegen aan InfluxDB systeem meting
    Extraheert lnHelTuin-vbat en lnC3-vbat uit het MQTT JSON bericht
    en schrijft ze als lnHel_vbat en lnC3_vbat naar de systeem meting.
2026-05-11 Migratie naar tuinsensoren_v3 bucket
    Node-RED schrijft naar nieuwe lege bucket tuinsensoren_v3.
    Grafana dashboard (v17) leest alle 27 queries uit tuinsensoren_v3.
2026-05-11 MQTT node: ESP32 temp sensor toegevoegd; Node-RED: hel_temp opslaan
    MQTT sketch stuurt hel_temp (ESP32-S3 interne temp) mee in JSON.
    Node-RED schrijft hel_temp naar systeem meting in InfluxDB.
    Grafana: behuizing panel fix (override mismatch bh1750), agg+bh1750
    zelfde kleur (orange), lnC3 temp_mesh en lnHelTuin hel_temp toegevoegd.
    [CLAUDE_LORA_VV_RECEIVER_MQTT_HELTEC_V1.ino]
2026-05-11 Heltec TX: loop() herhaalt UART→TX cyclus (V3)
    Was eenmalig in setup() waardoor batterijmeting nooit bijwerkte na opladen.
    Nu wacht loop() steeds opnieuw op UART data en TX via LoRa.
2026-05-11 Revert: MQTT node heeft geen JST batterij, wordt via USB gevoed
    lnHelMqtt-vbat en read_vbat_mv() teruggedraaid — geen batterij op JST.
    [CLAUDE_LORA_VV_RECEIVER_MQTT_HELTEC_V1.ino]
2026-05-11 Node-RED: lnHelTuin_tbat opslaan in InfluxDB
    T-BAT spanning (via 0-25V sensor op GPIO4 MQTT node) werd al gemeten
    en meegestuurd in MQTT payload, maar nooit opgeslagen in InfluxDB.
2026-05-11 Node-RED: vbat_mesh en temp_mesh verwijderd uit systeem meting
    Restanten van oud Meshtastic systeem — mv werd nooit gestuurd (altijd 0),
    mc was case temp van een niet meer bestaande mesh node.
2026-05-11 Node-RED: DHT22 aparte influx functie, mqtt_case_temp uit LoRa flow
    influx_function_dht22.js: nieuw, voor topic tuin/mqtt/dht22
    Slaat mqtt_case_temp en mqtt_hum op in meting mqtt_dht22.
    mqtt_case_temp (chip temp) verwijderd uit hoofdflow influx_function.js.
2026-05-11 Wemos V2: powerbank keepalive + DHT22 meting naar MQTT
    Combineert microWakeUpper keepalive (bootstroom houdt powerbank wakker)
    met DHT22 temperatuur/vochtigheid naar tuin/mqtt/dht22.
2026-05-12 Receiver V2: periodieke statuspublicatie + Node-RED influx functie
    Elke 30s publiceert de receiver uptime, rx_total, rx_mqtt_ok,
    rssi_lora en wifi_rssi naar tuin/receiver/status zodat Grafana
    receiver-activiteit toont ook zonder inkomende LoRa data.
2026-05-12 Receiver V2: setBufferSize(512) voor grote LoRa JSON payloads
    Standaard PubSubClient buffer (256 bytes) is te klein voor de
    volledige sensor payload. publish() gaf stilletjes false terug.
2026-05-14 Node-RED: uptime seconden naar uren in receiver status flow
2026-05-14 Node-RED + Grafana: migratie naar tuinsensoren_v4
    - Alle Node-RED functies: bucket v3→v4, nieuwe token
    - Grafana dashboards: 42 queries omgezet naar v4
2026-05-14 Receiver V3: fix Adafruit_Si7021 library naam (kleine i)
    [CLAUDE_LORA_VV_RECEIVER_MQTT_HELTEC_V3.ino]
2026-05-14 Receiver V3: SI7021 directe I2C zonder library
2026-05-15 Sensorstation node toevoegen: ESP32-C3 Super Mini + BH1750 + SHT3x
    Nieuw device (node id=5, wake :24) stuurt lux, temp en vochtigheid
    via ESP-NOW naar AGG. AggUplink97 uitgebreid van 5 naar 6 slots
    (119 → 141 bytes). LoRaNode C3 decodeert nieuw "st" JSON-veld.
    Node-RED schrijft naar InfluxDB measurement "sensorstation".
    Grafana dashboards bijgewerkt met lux, temp, vochtigheid en RSSI panels.
    MAC van STNST nog invullen in AGG na eerste flash.
2026-05-15 AGG: MAC sensorstation (STNST) ingevuld
2026-05-15 Sensorstation: TEST_SLEEP_SEC=30 voor synchronisatietest
    Zet TEST_SLEEP_SEC op 0 voor productie (dan DS3231 RTC timing).
2026-05-15 create_dashboards.py: bucket v3 → v4
2026-05-15 Sensorstation: vaste 30s timer sleep, geen DS3231
2026-05-15 Sensorstation: BME280 toevoegen (casetemp + luchtdruk)
    BME280 op I2C 0x76 levert casetemp (case_x10) en luchtdruk
    (ph_x10, hPa × 10). DS3231 code verwijderd. "st" JSON array
    uitgebreid naar 7 elementen met druk op positie 4.
    Node-RED en Grafana bijgewerkt.
2026-05-15 BME280 testsketch voor Super Mini (I2C scan + beide adressen)
2026-05-15 Sensorstation: BME280 vervangen door SI7021 (casetemp, geen druk)
2026-05-15 Sensorstation: SI7021 verwijderd, terug naar BH1750 + SHT3x
2026-05-16 Sensorstation: VBAT ADC fix voor springende readings
    - Expliciete ADC_11db attenuation (0-2500mV range)
    - 5 weggooi-reads voor stabilisatie bij 100K/100K bronimpedantie
    - Delay 5ms tussen samples i.p.v. 2ms
2026-05-16 Sensorstation: VBAT mediaan filter tegen ESP32-C3 ADC ruis
    20 samples, sorteer, middelste 10 middelen (gooit uitschieters weg)
2026-05-16 Sensorstation: VBAT_RATIO 3.2 voor 220K/100K spanningsdeler
2026-05-17 Waterflow: NVS reset via webknop
    Reset-knop op webpagina (POST /reset) zet totaal, grafiekbuffer en NVS op 0.
    [xiao-waterflow-yf201b.ino]
2026-05-17 Waterflow V1: cumulatief NVS + GPIO resetknop bij boot
    totalLiters wordt elke 5 min opgeslagen in NVS. Resetknop op GPIO2 (D0)
    ingedrukt houden bij inschakelen wist het totaal naar 0.
2026-05-17 Waterflow V1: FLOW_PIN gecorrigeerd naar GPIO4 (D2)
2026-05-17 Flowtest: MOSFET D4 altijd aan voor sensortest
2026-05-17 Waterflow V102: MOSFET D4 toegevoegd, vast aan (switch volgt later)
2026-05-17 Waterflow V103: deep sleep + waterflow switch op D3
    Waakt op GPIO5 (D3) LOW. MOSFET aan bij wakeup, meet 10s,
    stuurt naar AGG, slaapt weer. D3→GND simuleert waterflow switch.
2026-05-17 Waterflow V105: verstuur elke 25s tot ack=1, dan NVS+sleep
    Flow elke 5s berekenen, elke 25s naar AGG sturen. Na ack=1:
    NVS opslaan en deep sleep. Telt door zolang geen ack.
2026-05-19 Sensorstation V2: DS18B20 (GPIO6) + voltage divider
    - DS18B20 waterproof temp sensor op GPIO6 via OneWire/DallasTemperature
    - case_x10 veld nu DS18B20 temp × 10 (was BME280, ongebruikt)
    - Flag bit 0x0004 voor DS18B20 OK status
    - Bestaande voltage divider (220K/100K, ratio 3.2) ongewijzigd
2026-05-19 Sensorstation V2: fix VBAT_RATIO en DS18B20 pin
    - VBAT_RATIO 3.2 → 1.46 (gekalibreerd: 3.77V bat / 2.60V divider)
    - DS18B20 pin 6 → GPIO2 (GPIO6-11 zijn SPI flash op ESP32-C3)
    [CLAUDE_LORA_VV_SENSORSTATION_V2.ino]
2026-05-20 Voeg FSD v0.4 toe (bijgewerkt vanuit v0.2)
    20-min cyclus, BH1750/Waterflow/Sensorstation toegevoegd, Heltec RX
    i.p.v. T-Beam, stroomopstelling bijgewerkt, JSON-formaat uitgebreid.
2026-05-21 Voeg FSD v0.5 toe
    Bijgewerkt vanuit v0.4: alle nodes beschreven (kas/sensorstation, BH1750,
    waterflow, lnHel, MQTT node); RSSI per node toegevoegd; kas gecorrigeerd
    (30s timer, geen DS3231, BH1750+SHT3x+DS18B20); timing tabel uitgebreid;
    JSON gecorrigeerd (r-veld, wf-semantiek, hel_temp toegevoegd).
2026-05-25 Waterflow V107: interrupt voor MOSFET koppelen
    Voorheen werd de MOSFET (5V naar YF-201B) aangezet vóór de flow interrupt
    gekoppeld was, waardoor pulsen gemist werden bij opstart. Interrupt wordt
    nu als eerste geconfigureerd zodat geen enkele puls verloren gaat.
2026-05-28 Cyclustijd gewijzigd van 20 naar 10 minuten in alle nodes
    INTERVAL_MINUTES: 20 → 10 in AGG, BH1750, SOIL1, SOIL2 en LoRa C3.
    lnHel timing-comment bijgewerkt (altijd-aan node).
2026-05-28 Cyclustijd teruggezet naar 5 minuten (was 10)
    INTERVAL_MINUTES: 10 → 5 in AGG, BH1750, SOIL1, SOIL2 en LoRa C3.
    10-minuten cyclus werkte niet; 5 minuten was de laatste werkende instelling.
2026-05-29 v2 afgerond: FSD v0.6, cyclus 10 min, vbat kalibratie bijgewerkt
    - FSD v0.6: sensorstation buiten scope, cyclus 20→10 min, vervolgstappen bijgewerkt
    - README: interval 20→10 min in nodes tabel en timing sectie
    - influx_function.js: nieuwe vbat factoren (agg/soil2/lnc3/lnhel) op basis van multimetermeting; soil1 ph +2.0 offset
